Tech500/Heating-System-Monitor-III/Images/Project Average Current.png

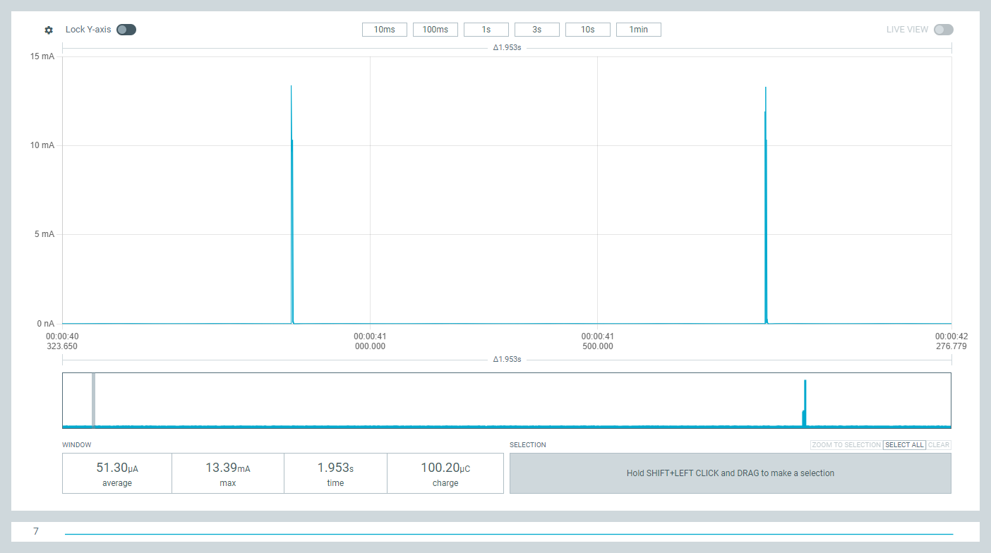
Images/Project Average Current.png
