Tech500/Heating-System-Monitor-III/Images/Sleep Duration.png

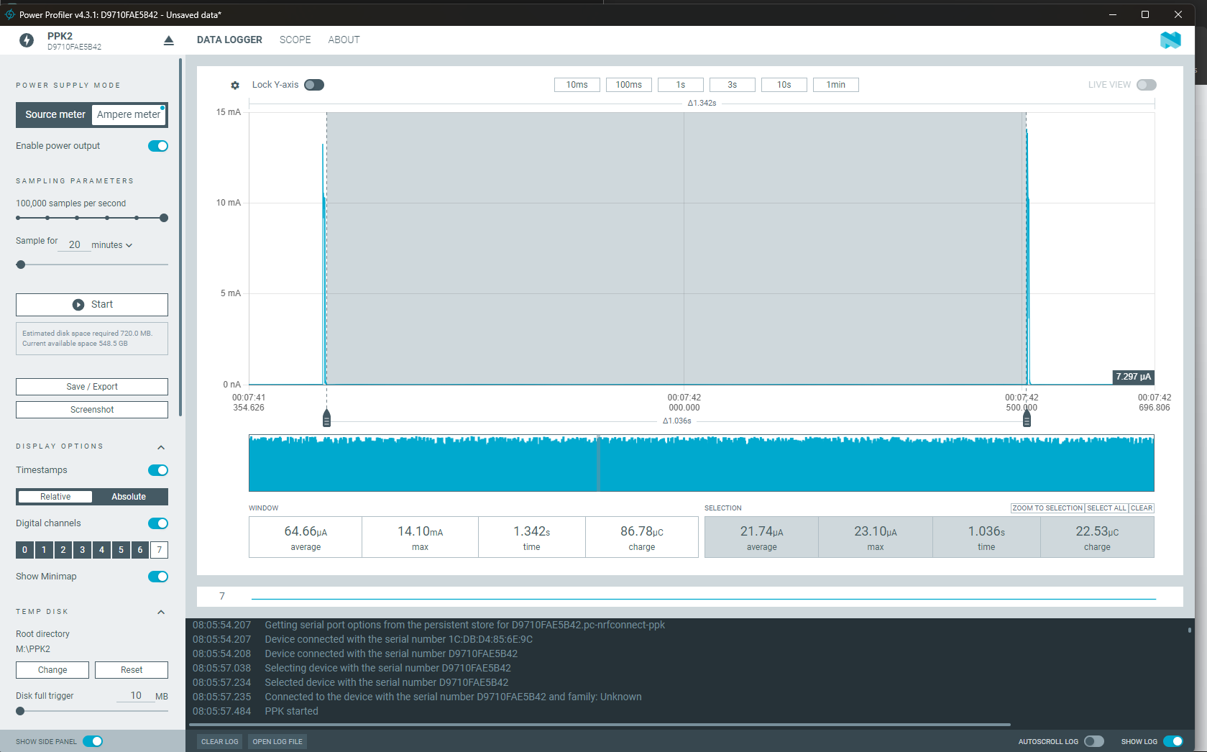
Images/Sleep Duration.png
