Tech500/Heating-System-Monitor-III/Images/WOR Spike and Deep Sleep.png

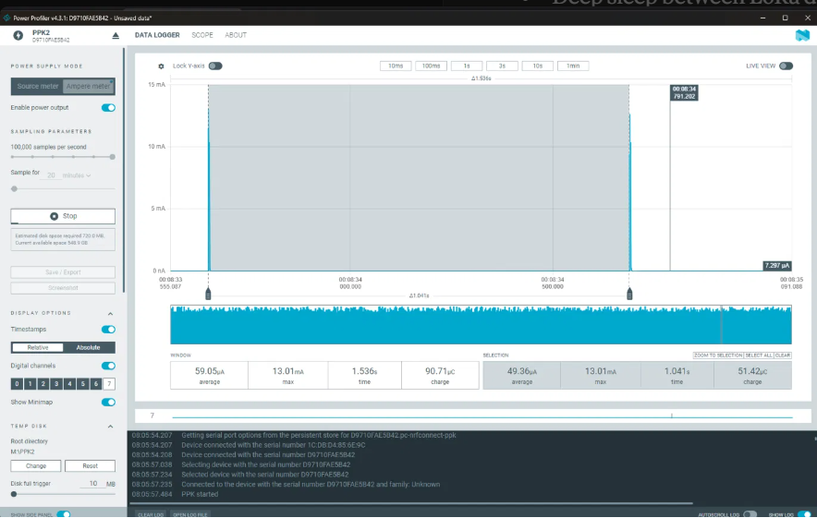
Images/WOR Spike and Deep Sleep.png
