Tech500/Heating-System-Monitor-III/Images/WOR Spike Duration.png

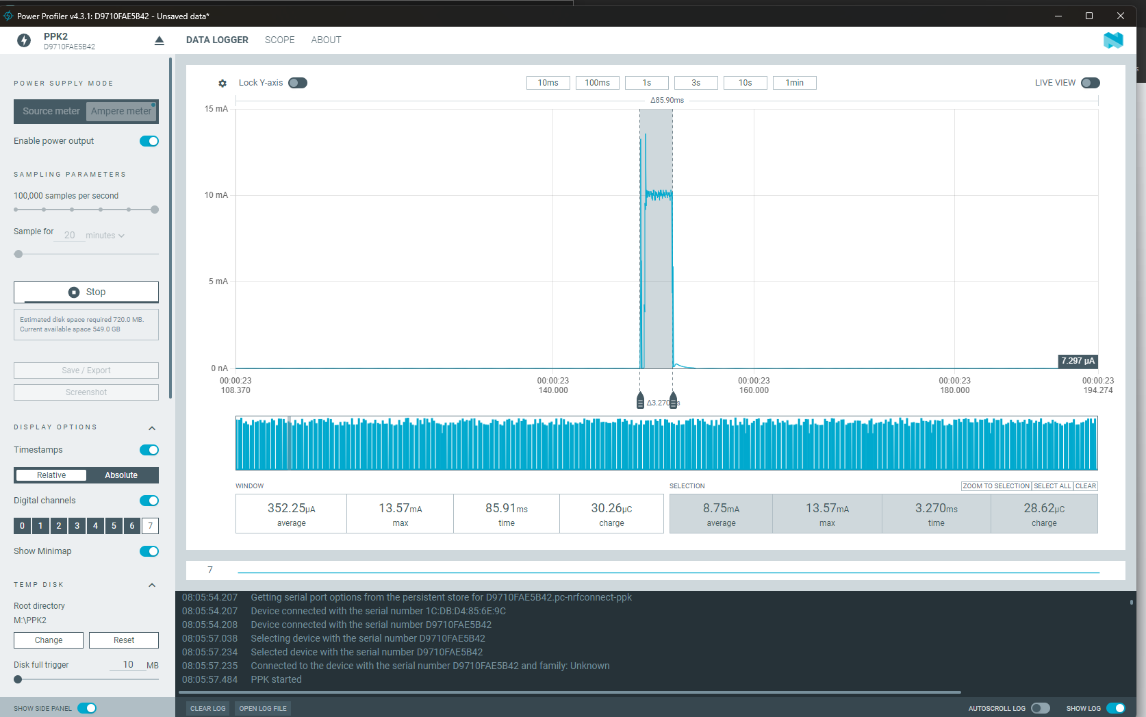
Images/WOR Spike Duration.png
