Tech500/Heating-System-Monitor-III/Schematics/ESP-NOW Outside Node Schematic.png

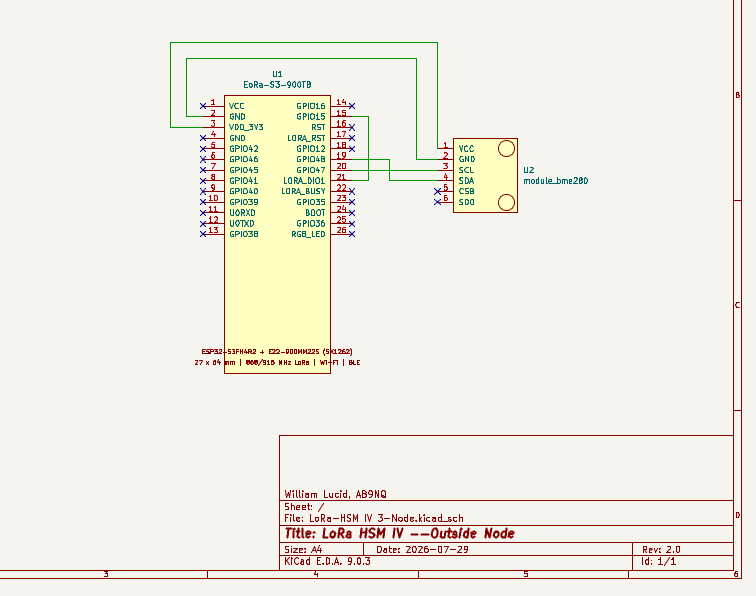
Schematics/ESP-NOW Outside Node Schematic.png
