Tech500/Heating-System-Monitor-III/(commit log)

2026-07-26 Revise project description for ESP-NOW BME280 node
    Updated project description to reflect new direction using CAD detection for LoRa preamble. Clarified functionality and power requirements.
2026-07-26 Revise project to use CAD for LoRa preamble detection
    Updated project direction to utilize CAD detection for LoRa preamble, improving power efficiency in deep sleep mode.
2026-07-26 Revise project to use CAD detection for ESP-NOW
    Updated project direction to utilize CAD detection for waking ESP-NOW BME280 node from deep sleep to send readings.
2026-07-29 Refactor ESP-NOW BME280 node for efficiency
    Updated ESP-NOW BME280 sensor node to improve wake-up mechanism and power management. Adjusted pin configurations, added comments, and refined the deep sleep process.
2026-07-29 Update return to auto duty cycle
    Could not get CAD to work with wake on radio; everything worked except no EXT0 wake up.
2026-07-29 Modify WiFi credentials and BME280 calibration offset
    Updated WiFi credentials and calibration offset for BME280 readings.
2026-07-29 Update temperature calibration and security settings
2026-07-29 Add ESP32 Core version to comments
    Updated comments to include ESP32 Core version.
2026-07-29 Fix formatting in Nordic PPK2 Power Observations.md
2026-07-30 Optimize BME280 sensor node code for ESP32
    Optimized BME280 sensor node code for ESP32 Core 3.3.10. Updated configuration, improved telemetry sending, and refined deep sleep handling.
2026-07-31 Fix image link in Nordic PPK2 Power Observations
    Updated image link for Project Average Current.
2026-07-31 Fix image path for Project Average Current
2026-07-31 Fix image link for Project Average Current
2026-07-31 Fix image syntax in Nordic PPK2 Power Observations.md
2026-07-31 Update Nordic PPK2 Power Observations.md
2026-07-31 Fix headings and image link in power observations
    Updated section headings and corrected image link formatting.
2026-07-31 Refactor Nordic PPK2 Power Observations documentation
    Updated markdown formatting and corrected image links for clarity.
2026-07-31 Rename Project Aveage Current.png to Project Average Current.png
2026-07-31 Fix wording in README note about EBYTE boards
    Corrected the wording regarding power results in the note.
2026-07-31 Update EoRa-S3-900TB ordering instructions
    Added note about frequency regulation and ordering for EoRa-S3-900TB boards.
2026-07-31 Fix typo in ordering instructions for EoRa-S3-900TB
    Corrected a typo in the ordering instructions for the EoRa-S3-900TB boards in the README.
2026-07-31 Update Nordic PPK2 Power Observations with sleep details
    Added details about sleep duration and event-driven behavior during deep sleep.
2026-07-31 Update README with EBYTE EoRa-S3-900TB details
    Added notes about product requirements and links for EBYTE EoRa-S3-900TB boards.
2026-07-31 Update README with EoRa-S3-900TB product details
    Added product download links and notes for EBYTE EoRa-S3-900TB boards in the README.
2026-07-31 Update README with detailed ESP32 Core dependency
    Clarified dependencies for ESP-NOW and peripheral shutdowns.
2026-08-02 Enhance Nordic PPK2 Power Observations documentation
    Added detailed notes and images for PPK2 power measurements, including average current and sleep durations.
2026-08-02 Revise power metrics and add selection details
    Updated power observation metrics for Nordic PPK2.
2026-08-02 Revise power observation metrics in documentation
    Updated average current and sleep duration values for power observations.
2026-08-02 Update power observation metrics for selection
2026-08-05 Refactor to use Channel Activity Detection for power savings
    Refactor ESP32-NOW BME280 sensor node to implement Channel Activity Detection (CAD) for lower power consumption. Update radio initialization, message structures, and setup functions.
2026-08-05 Fix markdown link formatting in comments
    [ESP_NOW_BME280.ino]
2026-08-05 Revise CAD observations date and formatting
    Updated documentation date and formatting for CAD observations.
2026-08-05 Enhance ESP_NOW_Receiver with button support
    Added button functionality and updated LoRa preamble length.
2026-08-28 Update WiFi credentials in Print_Hub_MAC_Channel.ino
